wilkoer/FollowFocus/(commit log)

2015-07-24 implemented timer function to send data to arduino
2015-08-30 second version for arduino code
2015-08-30 arduino v2 repair update
2015-08-30 high & low endmark filtering
2015-09-08 Überarbeitung Paper
    Bilder ref + label
    Code kommentiert
    Sprache korrigiert
    [code.c]
2015-09-18 calibration added
2015-09-19 laser cutting file
2015-09-26 endmarks arduinoseitig
